HCRXchenghong/drive-by-wire-chassis/调试脚本/usb_can_rear_drive_steering_test.html

# USB-CAN 后驱双驱轮 / 前转向测试

这个页面只做两类真实调试：后驱双驱轮 MSSD 控制器测试，以及前转向 MSSC 控制器测试。现在已按你的接法改成两个独立 COM 口：驱动控制器一个 USB-CAN，转向控制器一个 USB-CAN，互不抢占、互不混线。

## 1. 双 USB-CAN 连接

驱动侧只接后驱双驱轮 MSSD 控制器，转向侧只接前转向 MSSC 控制器。两个适配器都按 SLCAN 方式通过 Web Serial 连接，默认串口 115200，默认 CAN 速率 S6 / 500 kbps。

### 驱动 USB-CAN（MSSD）

SLCAN CAN 速率命令

选择驱动串口 重新打开驱动 CAN 读取驱动适配器版本 断开驱动串口

驱动连接状态未连接

驱动串口未选择

驱动适配器版本--

### 转向 USB-CAN（MSSC）

SLCAN CAN 速率命令

选择转向串口 重新打开转向 CAN 读取转向适配器版本 断开转向串口 清空日志

转向连接状态未连接

转向串口未选择

转向适配器版本--

## 2. 后驱双驱轮 MSSD

右轮目标转速寄存器使用 0x39 / 0x3A，左轮目标转速寄存器使用 0x3D / 0x3E。右轮真实转速读取 0x09 / 0x0A，左轮真实转速读取 0x14 / 0x15。本页会把发包、停轮、急停、回读都固定走驱动 USB-CAN。

驱动 CAN ID

测试 RPM（正值）

测试时长（秒）

测试前后自动读取轮速

普通停止后追加急停

快捷测试

双轮正转测试 双轮反转测试 右轮正转测试 右轮反转测试 左轮正转测试 左轮反转测试

自定义左右轮 RPM

右轮 RPM

左轮 RPM

执行自定义双轮测试 读取实际轮速 普通停止 急停

右轮实际 RPM--

左轮实际 RPM--

驱动反馈帧数0

## 3. 前转向 MSSC

转向速度命令使用 0x0031，停止使用 0x0030。进入速度闭环前会先写入 0x006B = 0 和 0x006C = 控制模式。位置回读使用 0x0013 / 0x0014，全部固定走转向 USB-CAN。

转向 CAN ID

转向测试 RPM（正值）

测试时长（秒）

控制模式

停止模式

停止后自动读位置

准备速度闭环 左转测试（负 RPM） 右转测试（正 RPM） 按输入方向发送 停止转向 读取转向位置

自定义 signed RPM（左负右正）

转向位置原始值--

位置反馈帧数0

方向说明左负 / 右正

## 4. 通讯日志

这里会分别记录驱动口和转向口的 SLCAN 指令、CAN 发包以及收到的原始回包，方便现场判断是没发出去、发错口、还是控制器没回包。
