HCRXchenghong/drive-by-wire-chassis/(list of files, drawings)

Other design files:
【正点原子】蓝牙串口模块ATK-BLE04/2，硬件资料/BLE.PcbLib
