HCRXchenghong/drive-by-wire-chassis/STM线控控制文件夹/STM32F407_Ackermann_Chassis/STM32F407_Ackermann_Chassis.ioc

Mcu.UserName=STM32F407ZGTx
PA0-WKUP.GPIO_Label=Throttle_ADC
PA0-WKUP.Signal=ADCx_IN0
PA1.GPIO_Label=Brake_ADC
PA1.Signal=ADCx_IN1
PA10.GPIO_Label=EWM22_RX
PA10.Signal=USART1_RX
PA11.GPIO_Label=USB_FS_DM
PA11.Signal=USB_OTG_FS_DM
PA12.GPIO_Label=USB_FS_DP
PA12.Signal=USB_OTG_FS_DP
PA13.Signal=SYS_JTMS-SWDIO
PA14.Signal=SYS_JTCK-SWCLK
PA2.GPIO_Label=Ext_UART_TX
PA2.Signal=USART2_TX
PA3.GPIO_Label=Ext_UART_RX
PA3.Signal=USART2_RX
PA9.GPIO_Label=EWM22_TX
PA9.Signal=USART1_TX
PB10.GPIO_Label=Gear_Mode_In
PB10.Signal=GPIO_Input
PB11.GPIO_Label=HW_ESTOP_In
PB11.Signal=GPIO_Input
PB12.GPIO_Label=Steer_CAN2_RX
PB12.Signal=CAN2_RX
PB13.GPIO_Label=Steer_CAN2_TX
PB13.Signal=CAN2_TX
PB8.GPIO_Label=Drive_CAN1_RX
PB8.Signal=CAN1_RX
PB9.GPIO_Label=Drive_CAN1_TX
PB9.Signal=CAN1_TX
PH0-OSC_IN.Signal=RCC_OSC_IN
PH1-OSC_OUT.Signal=RCC_OSC_OUT
