HCRXchenghong/drive-by-wire-chassis/STM线控控制文件夹/STM32F407_Ackermann_Chassis/Inc/main.h

#define Throttle_ADC_Pin GPIO_PIN_0
#define Throttle_ADC_GPIO_Port GPIOA
#define Brake_ADC_Pin GPIO_PIN_1
#define Brake_ADC_GPIO_Port GPIOA
#define Ext_UART_TX_Pin GPIO_PIN_2
#define Ext_UART_TX_GPIO_Port GPIOA
#define Ext_UART_RX_Pin GPIO_PIN_3
#define Ext_UART_RX_GPIO_Port GPIOA
#define Gear_Mode_In_Pin GPIO_PIN_10
#define Gear_Mode_In_GPIO_Port GPIOB
#define HW_ESTOP_In_Pin GPIO_PIN_11
#define HW_ESTOP_In_GPIO_Port GPIOB
#define Steer_CAN2_RX_Pin GPIO_PIN_12
#define Steer_CAN2_RX_GPIO_Port GPIOB
#define Steer_CAN2_TX_Pin GPIO_PIN_13
#define Steer_CAN2_TX_GPIO_Port GPIOB
#define EWM22_TX_Pin GPIO_PIN_9
#define EWM22_TX_GPIO_Port GPIOA
#define EWM22_RX_Pin GPIO_PIN_10
#define EWM22_RX_GPIO_Port GPIOA
#define USB_FS_DM_Pin GPIO_PIN_11
#define USB_FS_DM_GPIO_Port GPIOA
#define USB_FS_DP_Pin GPIO_PIN_12
#define USB_FS_DP_GPIO_Port GPIOA
#define Drive_CAN1_RX_Pin GPIO_PIN_8
#define Drive_CAN1_RX_GPIO_Port GPIOB
#define Drive_CAN1_TX_Pin GPIO_PIN_9
#define Drive_CAN1_TX_GPIO_Port GPIOB
