HCRXchenghong/drive-by-wire-chassis/STM线控控制文件夹/STM32F407_Ackermann_Chassis/Inc/steering_controller_mssc.h

#ifndef STEERING_CONTROLLER_MSSC_H
#define STEERING_CONTROLLER_MSSC_H

#include "main.h"
#include "can_transport.h"

#include <stdbool.h>
#include <stdint.h>

typedef struct
{
  CAN_HandleTypeDef *hcan;
  uint16_t node_id;
  uint16_t control_mode;
  uint32_t last_feedback_query_tick_ms;
  uint32_t last_feedback_ok_tick_ms;
  uint32_t feedback_timeout_count;
  uint32_t last_feedback_timeout_tick_ms;
  uint32_t last_seen_recovery_count;
  bool can_control_prepared;
  bool feedback_request_pending;
  bool feedback_fault_active;
  uint16_t position_high_word;
  uint16_t position_low_word;
  uint8_t position_words_valid_mask;
  uint8_t next_feedback_reg;
  uint32_t position_high_tick_ms;
  int32_t last_position_raw;
  uint32_t last_position_tick_ms;
} mssc_steering_controller_t;

void mssc_steering_controller_bind(mssc_steering_controller_t *controller,
                                   CAN_HandleTypeDef *hcan,
                                   uint16_t node_id,
                                   uint16_t control_mode);
bool mssc_steering_controller_prepare_for_can_control(const mssc_steering_controller_t *controller);
bool mssc_steering_controller_set_speed_rpm(const mssc_steering_controller_t *controller, int16_t speed_rpm);
bool mssc_steering_controller_set_speed_rpm_priority(const mssc_steering_controller_t *controller,
                                                     int16_t speed_rpm,
                                                     can_transport_priority_t priority);
bool mssc_steering_controller_stop(const mssc_steering_controller_t *controller);
bool mssc_steering_controller_stop_priority(const mssc_steering_controller_t *controller,
                                            can_transport_priority_t priority);
void mssc_steering_controller_feedback_process(mssc_steering_controller_t *controller);
void mssc_steering_controller_service(mssc_steering_controller_t *controller, bool enable_feedback_query);
bool mssc_steering_controller_get_position_raw(const mssc_steering_controller_t *controller,
                                               int32_t *position_raw,
                                               uint32_t *age_ms);
bool mssc_steering_controller_feedback_fault_active(const mssc_steering_controller_t *controller);
uint32_t mssc_steering_controller_feedback_timeout_count(const mssc_steering_controller_t *controller);
uint32_t mssc_steering_controller_last_feedback_ok_age_ms(const mssc_steering_controller_t *controller);
void mssc_steering_controller_invalidate_can_control_mode(mssc_steering_controller_t *controller);

#endif
