HCRXchenghong/drive-by-wire-chassis/(commit log)

2026-04-23 Initial wire-control scripts and docs
2026-04-26 feat: sync mobile app and chassis control
    [LoRa_radio_config_examples.txt]
2026-05-14 release: publish v1.0.0 chassis baseline
2026-05-14 docs: align v1.0.0 README and estop wiring
2026-05-14 docs: add ATK-BLE04 vendor materials
    [BLE.PcbLib]
2026-05-18 Release v2.0.1 configurable steering RPM
2026-05-24 Expand ROS2 and STM32 architecture diagrams
