HCRXchenghong/drive-by-wire-chassis/(notices)

Notices in the files:
STM线控控制文件夹/STM32F407_Ackermann_Chassis/Inc/main.h:
Copyright (c) 2026 STMicroelectronics.
All rights reserved.
This software is licensed under terms that can be found in the LICENSE file
